daisuke1017m/CluseControlDIY-Public/README.md

[ English ](README_en.md) | **日本語**

# [SUBARU インプレッサ STI GRB] ESP32 DIY クルーズコントロール(ASCD) & オートライト

ESP32マイコンを使用した実車用クルーズコントロール（ASCD）および自動ヘッドライト制御（オートライト）の統合システムです。  
実車の車速パルスとアクセルペダル位置信号（APPS）を取得・制御し、PID演算によって目標車速をリアルタイムに維持します。

---
> [!IMPORTANT]
>## ⚠️ 重要な免責事項（Safety Disclaimer）

> **警告:** 自動車の制御システム改造は事故や死亡に直結する重大なリスクを伴います。本リポジトリの内容は個人の実験記録および技術情報の共有を目的としたものであり、動作を保証するものではありません。導入・再現はすべて**自己責任**で実施し、公道でのテストは避けて安全な環境で行ってください。発生したいかなる損害・事故についても一切の責任を負いません。

> **注意:** 本プロジェクトは、GRB型インプレッサSTIをベースに開発されています。他の車種に適用する場合は、配線や制御パラメータを大幅に変更する必要があります。

> **注意:** 通常アクセルペダルは冗長出力されていて、車種によってはオフセットした電圧を持つ場合がある。この場合はオフセットをキープしなければ車両がフェールセーフに入ってしまう。しかしGRB型インプレッサでは2出力が同じ電圧になっているため、回路簡略化のためメイン信号のみを使用している。つまり2入力2出力のところ、1入力2出力としている。
---

## 1. システム概要

本システムは1台のESP32で以下の機能を独立して制御・モニタリングします。

1. **オートスピードコントロール（ASCD / クルーズコントロール）**
   - 車速をCANで受信し、純正ペダル電圧を計測しPID制御によるスロットル（APPS）電圧調整
   - TOYOTAのASCDスイッチを利用したI/F
   - ブレーキ割り込みおよび異常検知時の即時フェールセーフカットオフ
2. **オートライト制御**
   - エアコン用照度センサーを用いた周囲照度測定によるヘッドライト自動点灯・消灯(詳細の説明は割愛します)
3. **ステータス表示**
   - 0.96インチ OLED ディスプレイによる車速・設定状態のリアルタイム表示

---
## 2.開発プロセス（Vibe Coding & 実車検証）

本プロジェクトは、LLM/AIツールを活用した **バイブコーディング（Vibe Coding）** の手法を取り入れて開発しました。

- **AI（LLM）の活用:** 制御アルゴリズム（PID/状態遷移）の設計、スケッチのベースコード生成、データ構造の最適化
- **人間（開発者）による検証・担保:** 
  - 実車の信号線（APPS電圧・車速パルス）の物理テスター計測および補正
  - フォトカプラ絶縁やブレーキ物理リレーによるハードウェア優先フェールセーフの設計
  - 実走データに基づくPID制御パラメータのチューニングおよび安全性テスト
---

## 2. ディレクトリ構成とドキュメント導線

本リポジトリは Arduino IDE 標準のフォルダ構成を採用しています。詳細な仕様書やドキュメントは `Docs/` ディレクトリ配下の各ファイルを参照してください。

```text
.
├── Cruise_Control_DIY-Public.ino          # メインスケッチ（Arduino IDEでこのファイルを開きます）
├── Config.h                     # 各種ピンアサイン・パラメータ閾値の設定ヘッダー
├── PIDController.cpp / .h       # PID制御演算・I項クランプ・FFトレンドロジック
├── DataInput.cpp / .h           # CAN通信（OBD-II/パッシブ監視）・センサ入力処理
├── PedalIO.cpp / .h             # アクセルペダル（APPS）電圧読取・PWM出力・フェールセーフ制御
├── OledDisplay.cpp / .h         # OLEDディスプレイ描画・表示モード管理
├── AutoLight.cpp / .h           # オートライト制御ロジック
├── Control_Method.md            # 制御アルゴリズム・PID仕様詳細
├── LogicDiagram.md              # 制御ロジック概要図
├── OBD2_Supported_PIDs_v1.md    # 対応OBD-II PID一覧
├── README.md                    # 本ドキュメント（日本語）
├── README_en.md                 # 本ドキュメント（英語）
└── Docs/
    ├── Accel_Pedal.md           # 📑 [詳細] アクセルペダルピン配置・入力仕様
    ├── CAN.md                   # 📡 [詳細] CANバス通信仕様（OBD-II / パッシブモニタリング）
    ├── esp32_pinout.md          # 🔌 [詳細] ESP32 ピンアサイン・ハードウェア仕様
    ├── LogicFlowChart.md        # 🔄 [詳細] 制御ロジックフローチャート
    ├── LogicParameter.md        # ⚙️ [詳細] 制御パラメータ一覧・チューニングガイド
    ├── LogicState.md            # � [詳細] 状態遷移図（ステートマシン）
    ├── OLED.md                  # 🖥️ [詳細] OLEDディスプレイ仕様
    └── Control_Result_Sample.png # 📈 実走制御結果グラフ
```
---

## 3. 主要ピン割り当て概要

### ESP32 GPIOアサイン（抜粋）
- **入力系:** [アクセルMain (GPIO34)](Docs/Accel_Pedal.md), フォトレジスタ (GPIO36), クルーズSW (GPIO14), OLED表示切替 (GPIO33)
- **出力系:** アクセルPWM Main (GPIO26), オートライトリレー (GPIO15), ESP32 Ready (GPIO12)
- **通信系:** [OLED](Docs/OLED.md) I2C (SCL: GPIO22 / SDA: GPIO21), [CAN](Docs/CAN.md) (TX: GPIO17 / RX: GPIO16)

👉 **全ピンの詳細な仕様と回路構成:**
[esp32_pinout.md](Docs/esp32_pinout.md)

---

## 5. 回路設計と安全対策（フェールセーフ）

自動車環境特有のサージノイズと物理的安全性に対処するため、多重の保護回路を実装しています。

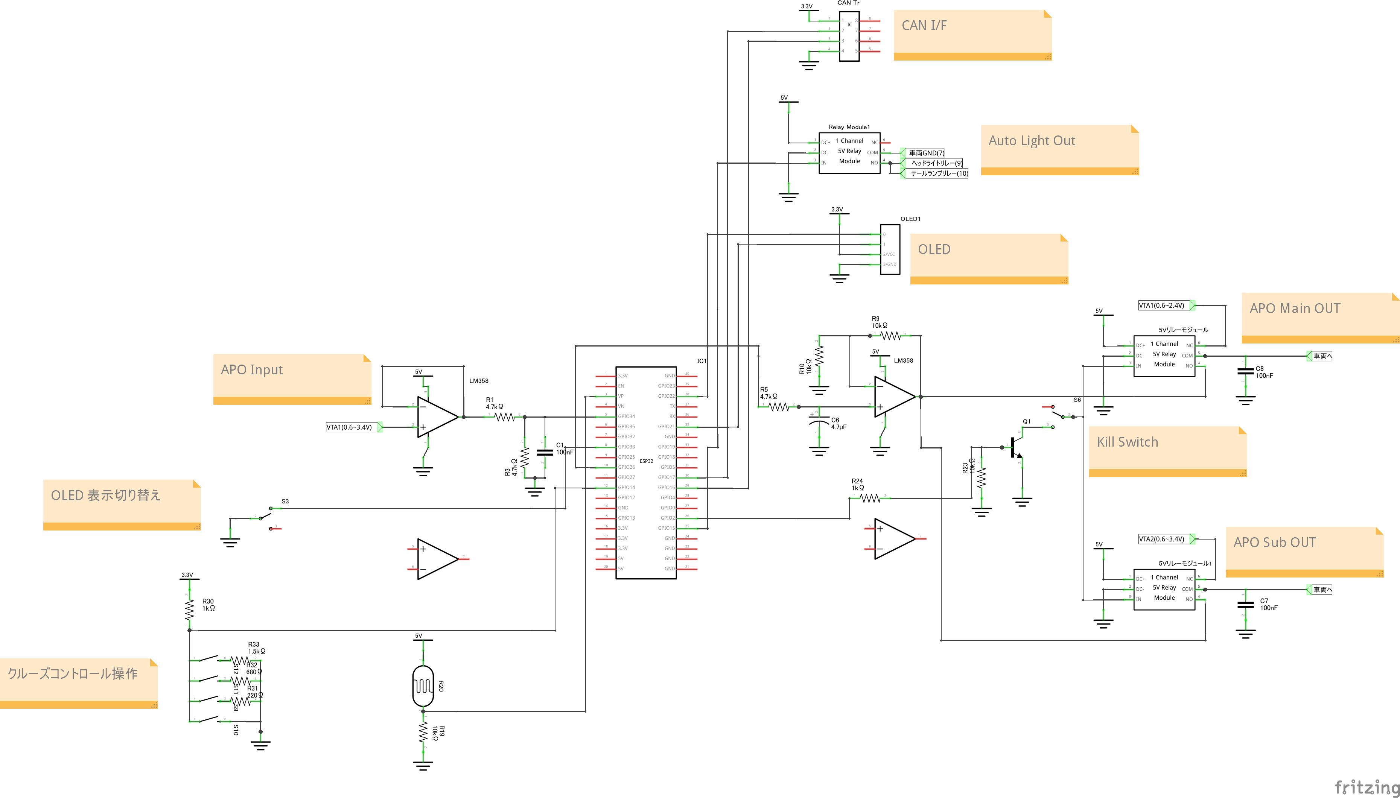
[picture p1: Docs/Cluse_Control_and_AutoLight_final.png]
回路図


1. **ハードウェア優先カット（最重要）:**
   ブレーキペダル踏み込み時は、ESP32の処理状態に関わらず物理リレーにより純正アクセル信号（APPS）へ強制復帰します。
2. **制御準備監視**
   処理がLoop()に入ってからKILL_SWITCH_PINをHIGHにし、この出力によりリレーがONになる。そこからPWM出力が車両側へ伝わる。

3. **電圧レベル変換 & 分圧保護:**
   実車のアクセル信号（0.6V〜3.5V）に対し、ESP32のADC上限（3.3V）を超えないよう抵抗分圧回路を配置。

👉 **配線特定ノウハウおよびアクセル信号仕様:** [Docs/Accel_Pedal.md](Docs/Accel_Pedal.md)

---
## 5. 制御概要

本クルーズコントロールシステムは、通常のPID制御に加えて実車（特にMT車および物理ブレーキ非連動環境）での追従性・快適性・安全性を確保するための様々な独自の制御工夫を盛り込んでいます。

### 5.1 PID制御とブレーキ非使用（アクセル制御のみ）による工夫点
物理ブレーキを作動させずアクセルペダル開度（PWM出力）のみで制御するため、滑らかな加減速とオーバーシュートの抑制、および下り坂・登坂路での追従性が重要となります。

👉 [ロジックフローチャート](Docs\LogicFlowChart.md)

- **ソフト不感帯（Soft Deadband）＆ 降下時非対称不感帯:**
  - 目標車速 $\pm 0.3\,\text{km/h}$ の範囲内では積分項（I項）の更新をストップ（ホールド）し、アクチュエータの過剰なハンチングを防ぎます。
  - **降下時非対称不感帯:** 車速が低下中、または目標を超過した状態から降下してくる際は、マイナス側の不感帯を $-0.05\,\text{km/h}$ と浅く自動切り替えし、目標車速を割り込む直前から早期にアクセル出力を立ち上げてボトム落ちを防ぎます。
- **動的I項クランプ（Floor保証付き `I_DECAY`）:**
  - 下り坂等で実車速が目標車速を $+1.0\,\text{km/h} \sim +4.0\,\text{km/h}$ 超過した際、超過量に応じてI項の上限（通常15%）を動的に引き下げ、超過後の過剰なアクセル残存を抑圧します。
  - 削りすぎによる目標割れ時の沈み込みを防ぐため、下限値（Floor: `3.0%`）を保証しています。
- **3秒車速トレンドによる予測フィードフォワード（`FF_TREND`）:**
  - 登坂路などで車速が落ち込む際、瞬間的なD項（微分）ノイズに左右されず、過去3秒間の車速低下量が `1.5 km/h` 以上かつ目標から `2.0 km/h` 以上離れた場合に予測的にアクセル開度を加算（最大 `5.0%`）し、追従遅れを解消します。
- **内部目標車速のランプ制御（`RAMP_UP`）:**
  - 設定車速変更時や復帰（Resume）時、急激な踏み込みショックを防ぐため、内部目標車速を `5.0 km/h/s` のレートリミットで滑らかに追従させます。
  - ドライバーのアクセル踏み込み（オーバーライド）時は内部目標速度を自車速に即時追従させ、離した後は1秒間のホールド時間を経てシームレスに制御を引き継ぎます。
- **折れ線Pゲイン（`P_HIGH`）:**
  - 車速差が $\pm 1.0\,\text{km/h}$ 以内は通常Pゲイン（`1.5`）、超過時は高Pゲイン（`3.0`）を適用し、大誤差時からの素早い復帰を実現しています。

### 5.2 MTへの対応 (クラッチを踏んでギアを変える時の制御)
- **変速中の制御一時抑制と上位ギア自動追従:**
  - クラッチペダル切断（`clutchReleased == false`）時、切断直前のギアを記憶します。
  - シフトチェンジ中、エンジン回転数低下等により記憶したギアより上位のギア段が検出された場合のみ、半クラッチでギアが接続し始めたと判断して自動的にPID制御を再開します。
  - 同一ギアのままやニュートラルの場合は、エンジンの空吹かしを防ぐため出力を即座に `0%` に制限します。

### 5.3 MTへの対応 (ニュートラルに入れた時の制御)
- **ニュートラル（Gear: 0）自動キャンセル:**
  - クラッチ切断からニュートラル位置でクラッチが離された場合、空吹かしや意図しない加速を防ぐため、ブレーキを踏んだ際と同様に**クルーズ制御を自動キャンセル**します（目標車速は保持されるため、後にResume操作可能）。

### 5.4 MTへの対応 (エンジンブレーキによるギクシャクを抑える)
- **オーバーライド操作時の積分項バックキャルキュレーション（`syncIntegral`）:**
  - ドライバーがアクセルを踏み込んでクルーズ制御を一時的に追い越した（オーバーライド）際、PIDの計算値より実アクセル開度（`realPedalADC`）が大きければ、実アクセル開度に相当するI項をバックキャルキュレーション（逆算・同期）します。
  - これにより、追い越し後にアクセルを急に離した際、PID出力と実アクセル開度がスムーズに接続され、急激なエンジンブレーキによるギクシャク感（ショック）の発生を完全に防ぎます。
- **セレクトハイ（Select-High）出力制御:**
  - PID計算出力と実アクセルペダル開度のうち、常に大きい方の開度をPWMとして採用し、ドライバーの意図した加速操作を妨げません。
## 6. 状態遷移

本クルーズコントロールシステムは、安全性の確保とMT車特有の操作性（シフトチェンジ・空吹かし防止）に対応するため、以下の4つの主要状態（ステート）を遷移します。

- **`STANDBY` (初期状態):** 目標車速が未設定の状態。
- **`OFF_READY` (制御待機):** ブレーキ踏み込み、CANCEL操作、ニュートラル判定等により制御が待機状態。設定車速は保持されResume可能。
- **`ACTIVE_DRIVING` (制御中):** 設定目標車速に向けてPID演算およびアクセルPWM出力を行っている状態。
- **`ACTIVE_CLUTCH` (MTシフト中):** クラッチ切断中の一時状態。エンジンの空吹かしを防ぐため出力を0%制限（ただしシフトアップ判定時は先行PID出力）。

👉 **詳細なステートマシン図・遷移条件フローチャート:** [Docs/LogicState.md](Docs/LogicState.md)

---

## 7. 実走制御結果

平坦路および勾配における、目標車速と実車速の追従性データです。

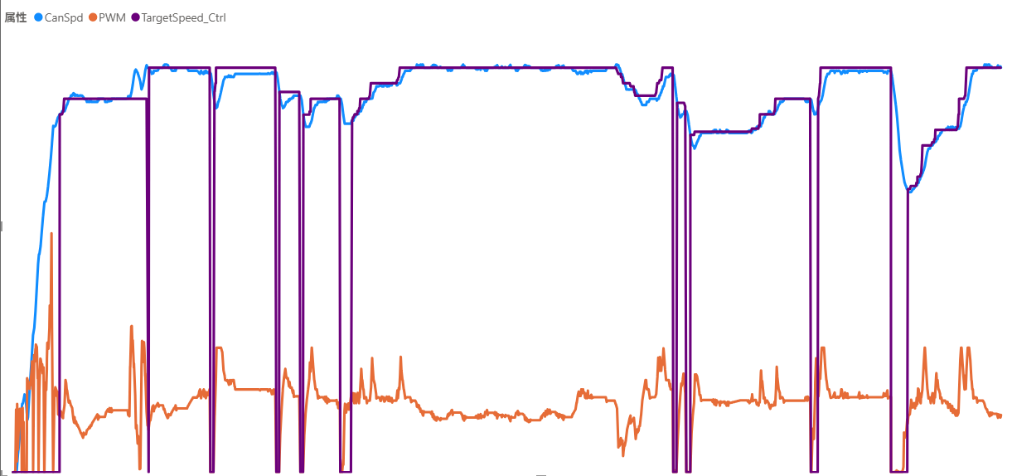
[picture p2: Docs/Control_Result_Sample.png]
車速制御結果グラフ


### グラフの解説とPIDチューニング
- **紫線:** 目標車速 (Target Speed) [km/h]
- **青線:** 実際の車速 (Actual Speed) [km/h]
- **オレンジ線:** 制御出力（アクセル指示値）[%]

---

## 8. 開発環境・セットアップ

1. **開発環境:** Arduino IDE
2. **使用ライブラリ:** `U8g2` (または `Adafruit_SSD1306`), `ESP32PulseCounter` 等
3. **調整**
   1. `config.h` 内のAPPS電圧上限/下限値が自車仕様と会うように調整します。

---

## 9. 開発中の注意点

### 8.1 アクセルペダル接続をしないで、車両電源をIGNにした場合
ECUは電圧を常に監視しているため、未接続のままIGN ONにしたり、正しい制御出力ができていない場合には車両がフェールに落ちます。ELM327などを用意してDTCを消せるようにしておくと良いでしょう。
