daisuke1017m/CluseControlDIY-Public/Docs/CAN.md

👈 [トップ（README.md）へ戻る](../readme.md)

# CAN通信仕様（データ取得・処理概要）

本システム（ESP32 DIY クルーズコントロール）では、ESP32内蔵のTWAI (Two-Wire Automotive Interface) ドライバを使用し、SUBARU インプレッサ STI (GRB) のCANバスから車両データをリアルタイム取得・監視しています。

---

## 1. CAN通信ハードウェア ＆ 動作仕様

- **物理層 / トランスシーバー:** CANトランシーバー（SN65HVD230）
- **終端抵抗**車両側に終端抵抗がついているのでモジュールについている120Ωは外した。
- **ピンアサイン:**
  - TX: `GPIO17`
  - RX: `GPIO16`
- **通信速度:** 500 kbps (`TWAI_TIMING_CONFIG_500KBITS`)
- **動作モード:** `TWAI_MODE_NORMAL`（送信・受信可能な双方向通信）
- **フィルター設定:** `TWAI_FILTER_CONFIG_ACCEPT_ALL()`（全IDメッセージを受信）
- **バスオフ自動復バリ機構:** バスオフ（`TWAI_STATE_BUS_OFF`）を検出した場合、自動的に `twai_initiate_recovery()` を呼び出して復旧および再スタート（`twai_start()`）を実施。

---

## 2. 取得データ一覧

取得データは**「パッシブ受信（標準CANフレーム）」**と**「アクティブポーリング（OBD-II Service 01）」**の2つに分類されます。

> [!IMPORTANT]
>  **OBD-IIデータ利用に関する注意点**  
> OBD-II経由で複数のパラメータ（車速、RPM、スロットル、ペダル開度、エンジン負荷）を取得していますが、**クルーズコントロールの主制御（PID制御ループ）のフィードバックデータとして直接利用しているのは「車速 (PID 0x0D)」のみ**です。  
> RPMはMTのギア判定、その他の項目はOLED表示やログ出力・デバッグモニタリング用途で使用しています。

### 2.1 パッシブ受信データ（標準CANフレーム）

CANバス上を定常的に流れているメッセージをリスニングして取得します。

| メッセージID (Hex) | 信号・項目 | 抽出・ビット演算 | 単位/形式 | 用途 |
| :---: | :--- | :--- | :---: | :--- |
| **`0x512`** | ブレーキスイッチ | `(rx_msg.data[4] & 0x10) != 0` | bool (ON/OFF) | **安全フェールセーフ** (ONで制御即時解除) |
| **`0x600`** | クラッチスイッチ | `(rx_msg.data[6] & 0x04) == 0` | bool (離している/踏んでいる) | **MTシフト制御** (クラッチ切断時の出力遮断) |

---

### 2.2 アクティブポーリングデータ（OBD-II Service 01）

ESP32から 50ms 周期で標準ID `0x7DF`（ブロードキャスト）に要求を送信し、ECU応答（ID `0x7E0`〜`0x7FF`）からデータを取得します。

- **リクエストID:** `0x7DF` (8バイト: `02 01 [PID] 00 00 00 00 00`)
- **レスポンス判定:** ID `0x7E0`〜`0x7FF`, Data[1] == `0x41`, Data[2] == 要求PID

| PID (Hex)  | データ項目 | 生データ計算式 | 変換・補正処理 | 主制御への利用 |
| :---: | :--- | :---: | :--- | :---: |
| **`0x0D`** | **車速 (Vehicle Speed)** | $A$ [km/h] | **10回移動平均（Moving Average）** を適用し、量子化ノイズ・スパイクを除去 | **⭕ 主制御使用** (PID制御のフィードバック車速) |
| **`0x0C`** | エンジン回転数 (RPM) | $\frac{256A + B}{4}$ [rpm] | 車速との比率（$\frac{\text{RPM}}{\text{Speed}}$）からギア段（1〜6速）を推定 | **❌ 補助利用** (ギア推定用) |
| **`0x11`** | スロットル開度 | $A \times \frac{100}{255}$ [%] | 純正電圧スケールに合わせた正規化補正 | **❌ 表示・ログ用** (PID制御には未使用) |
| **`0x49`** | アクセルペダル開度D | $A \times \frac{100}{255}$ [%] | `PEDAL_MIN(13.33%)`〜`PEDAL_MAX(65.49%)` で $0\sim100\%$ 正規化 | **❌ 表示・ログ用** (実ペダル制御はESP32のADC入力を使用) |
| **`0x04`** | エンジン負荷 (Engine Load) | $A \times \frac{100}{255}$ [%] | 生変換のみ | **❌ 表示・ログ用** |

---

## 3. データの活用と安全対策

1. **車速データの安定化 (10回移動平均):**
   - OBD-IIの車速データ（1km/h分解能）の粗さをカバーするため、最新10サンプルの移動平均（`currentSpeed`）を計算し、制御のハンチングを防止。
2. **ギア推定ロジック (`estimateGear()`):**
   - CAN車速とRPMの比率から現在何速に入っているか（10=1速, 20=2速 ... 60=6速, 0=N/クラッチ切断）を判定。ギア段ごとの最適PIDゲイン切り替えやMT安全制御に使用。
3. **CANエラー・タイムアウト監視:**
   - バスオフ検知時、または応答タイムアウト発生時は CANエラー状態（`canErrorState = true`）となり、クルーズコントロールを即座に安全キャンセルします。
